SG-O/MiniFeedMaster/README.MD

# Mainboard for automated SMT Feeder system #

## Documentation ##

You can find the manufacturing documentation [here.](https://github.com/SG-O/MiniFeedMaster/tree/master/Doc)

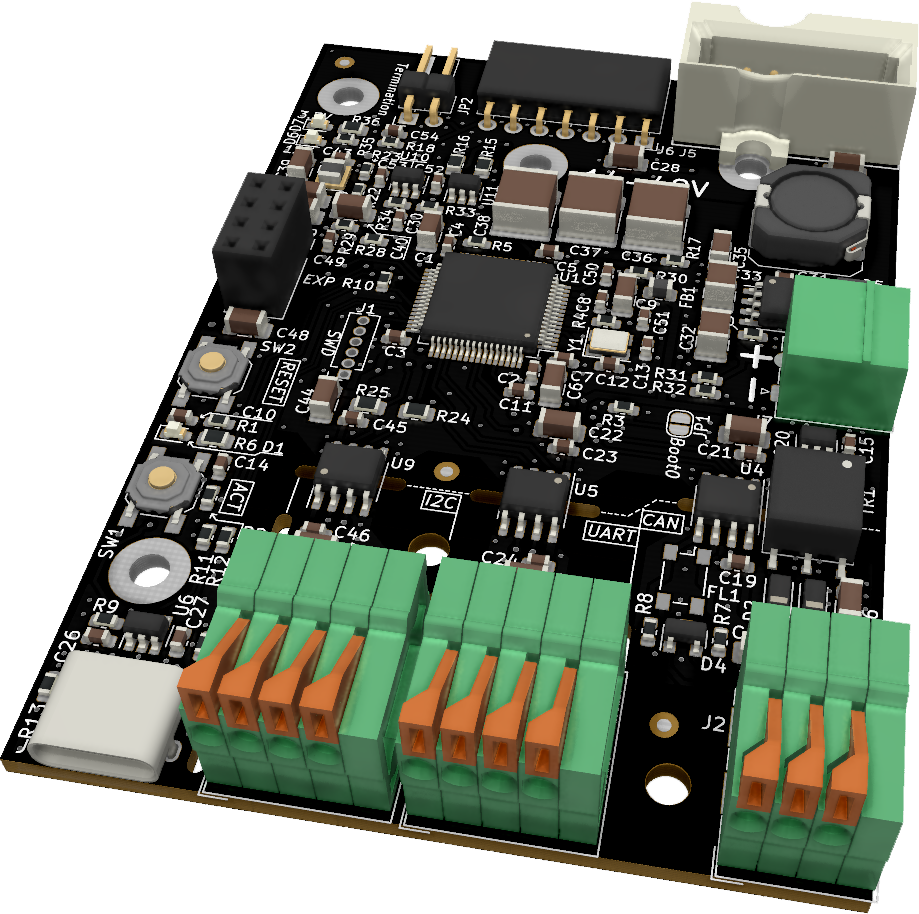
[picture p1: Doc/MiniFeedMaster1.png]
