SG-O/MiniFeedMaster/Doc/README.MD

# Manufacturing Documentation #

## Schematic ##

You can view the schematic [here.](https://github.com/SG-O/MiniFeedMaster/blob/master/Doc/MiniFeedMaster.pdf "Schematic")

## Gerber Files ##

Gerber files for this board can be found [here.](https://github.com/SG-O/MiniFeedMaster/releases "Releases")

## BOM ##

The BOM **without** the CAN circuit populated is available [here.](https://github.com/SG-O/MiniFeedMaster/blob/master/Doc/MiniFeedMasterBOM_nocan.csv "No CAN BOM")

The BOM **with** the CAN circuit populated is available [here.](https://github.com/SG-O/MiniFeedMaster/blob/master/Doc/MiniFeedMasterBOM_can.csv "CAN BOM")

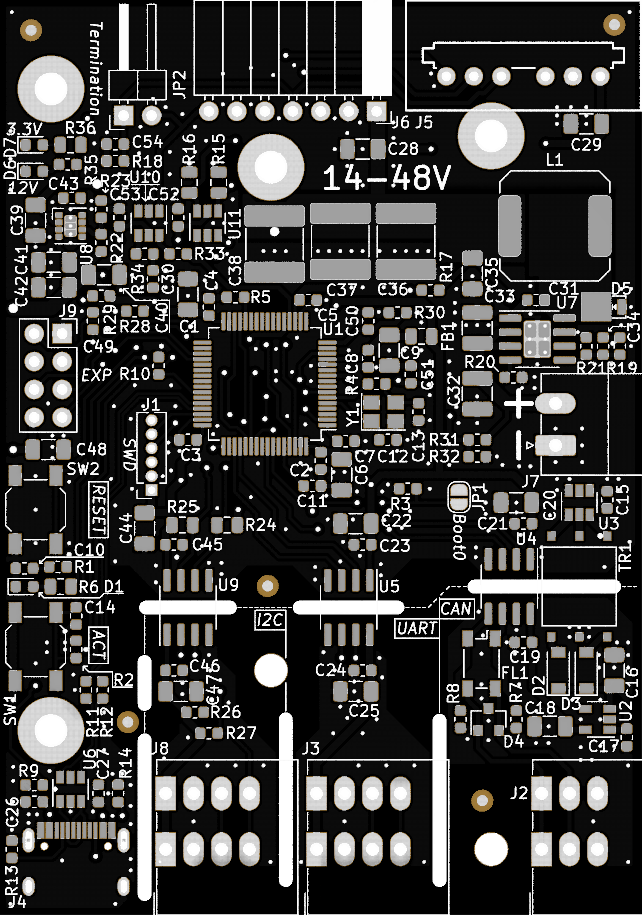
[picture p2: Doc/MiniFeedMasterTop.png]
