SG-O/MiniFeedMaster/Doc/MiniFeedMaster2.png

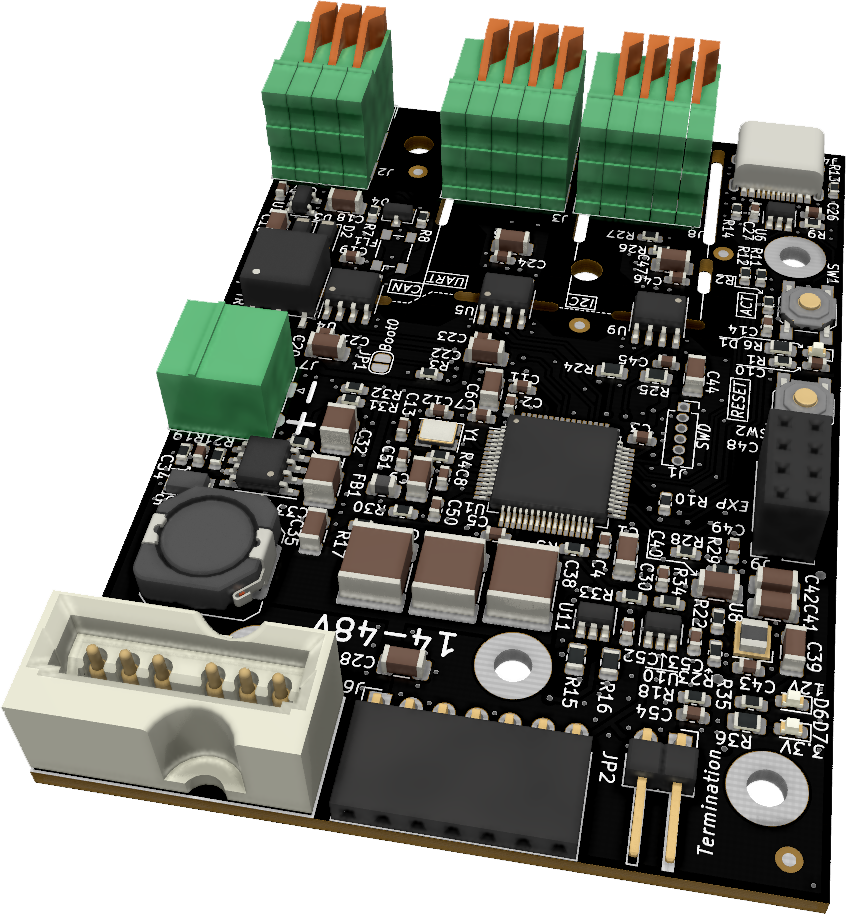
Doc/MiniFeedMaster2.png
