SG-O/MiniFeedMaster/Doc/MiniFeedMaster3.png

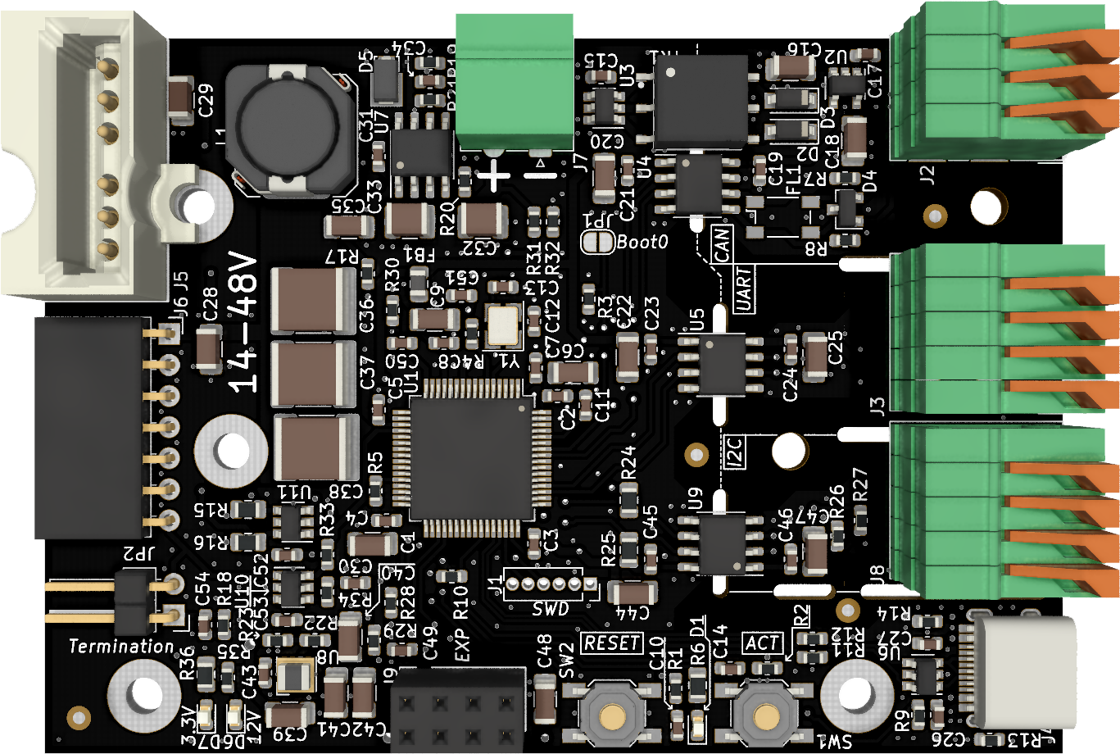
Doc/MiniFeedMaster3.png
