SG-O/MiniFeedMaster/Doc/MiniFeedMasterBottom.png

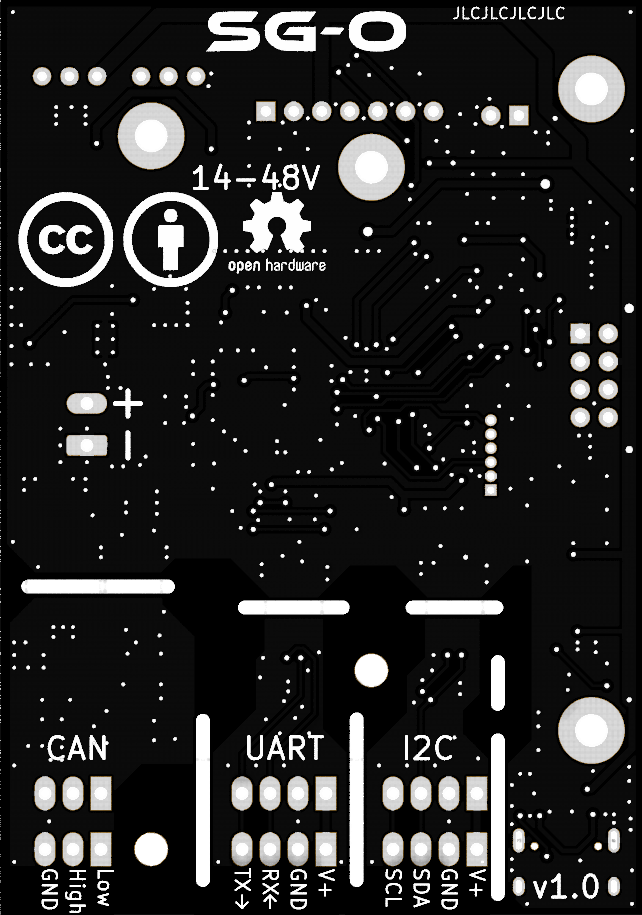
Doc/MiniFeedMasterBottom.png
