SG-O/MiniFeedMaster/Doc/MiniFeedMaster.pdf

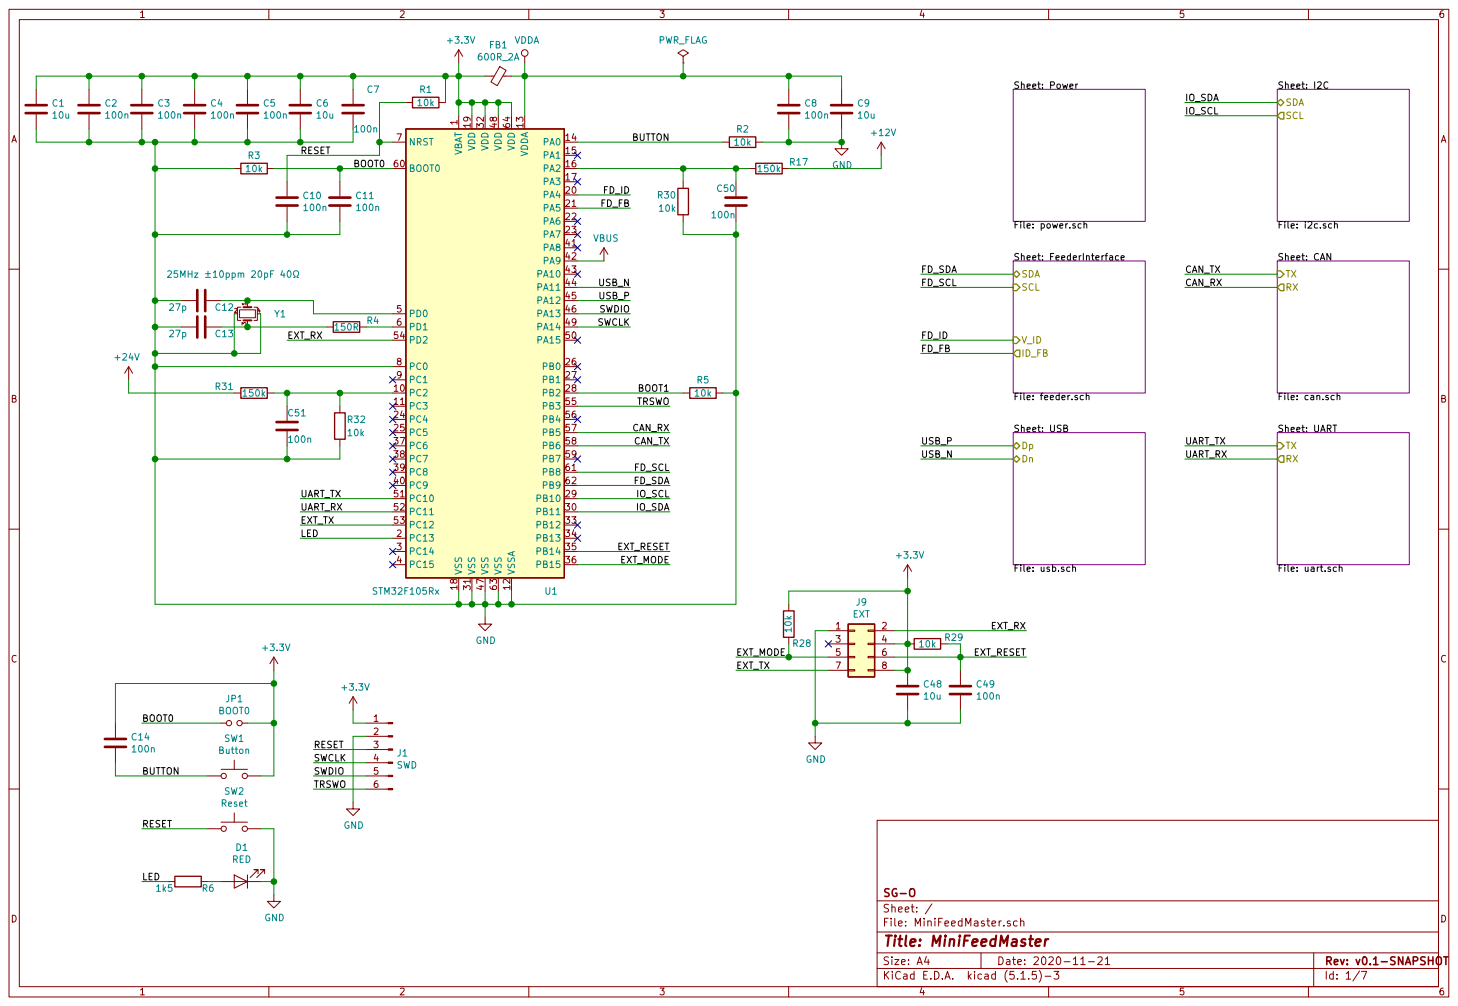
[picture p6: page 1]

File: usb.sch Dn Dp C3

File: i2c.sch SCL SDA

1 VDD 19 VDD 32 VDD 48 VDD 64 VDDA 13 VSS 18 VSS 31 VSS 47 VSS 63 VSSA 12 STM32F105Rx U1

Sheet: FeederInterface File: feeder.sch SDA
SCL V_ID

Sheet: CAN
File: can.sch TXRX

Sheet: UART
File: uart.sch TXRX

Id: 1/7 Title: MiniFeedMaster File: MiniFeedMaster.sch Sheet: / SG-O

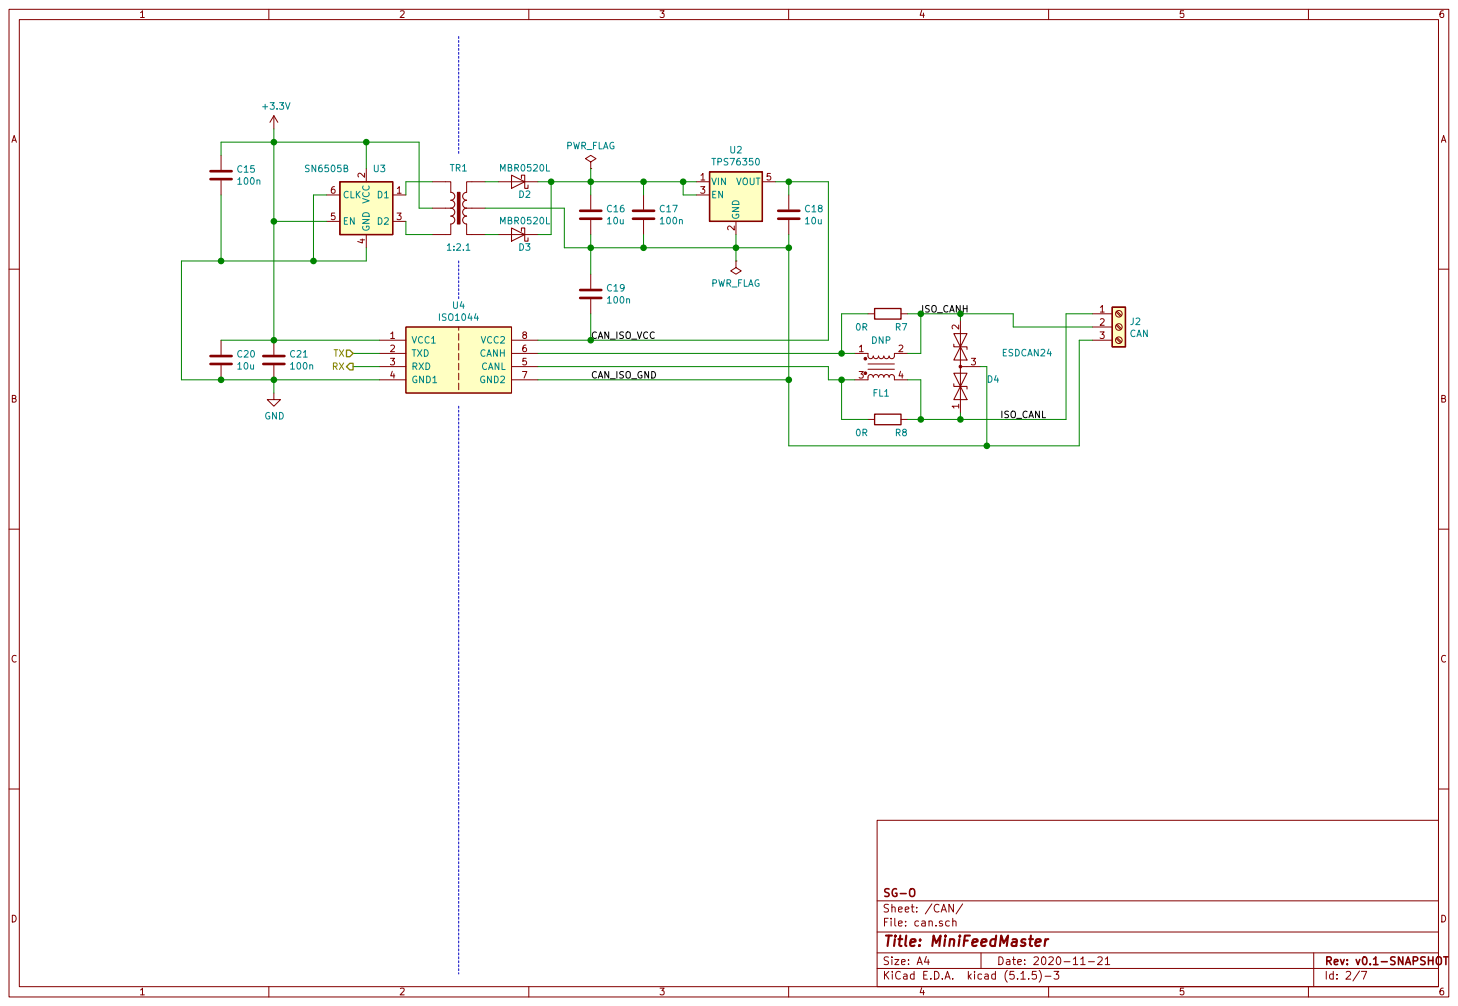
[picture p7: page 2]

Id: 2/7 Title: MiniFeedMaster File: can.sch Sheet: /CAN/ SG-O

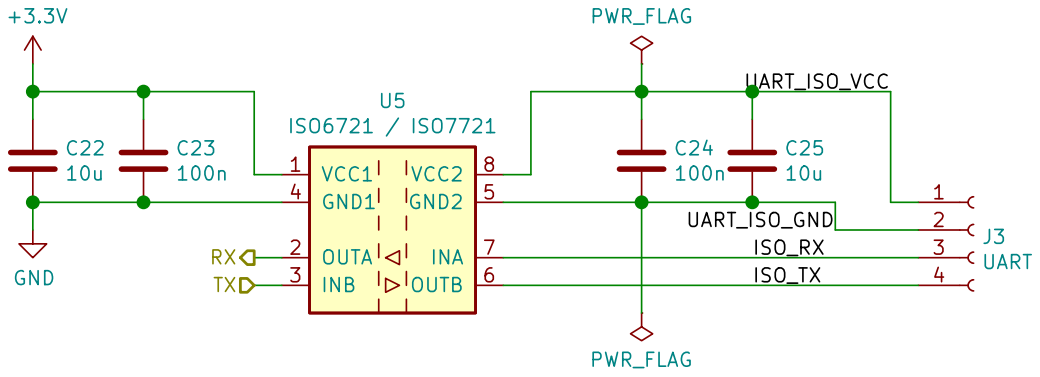
[picture p8: page 3]

Id: 3/7 Title: MiniFeedMaster File: uart.sch Sheet: /UART/ SG-O

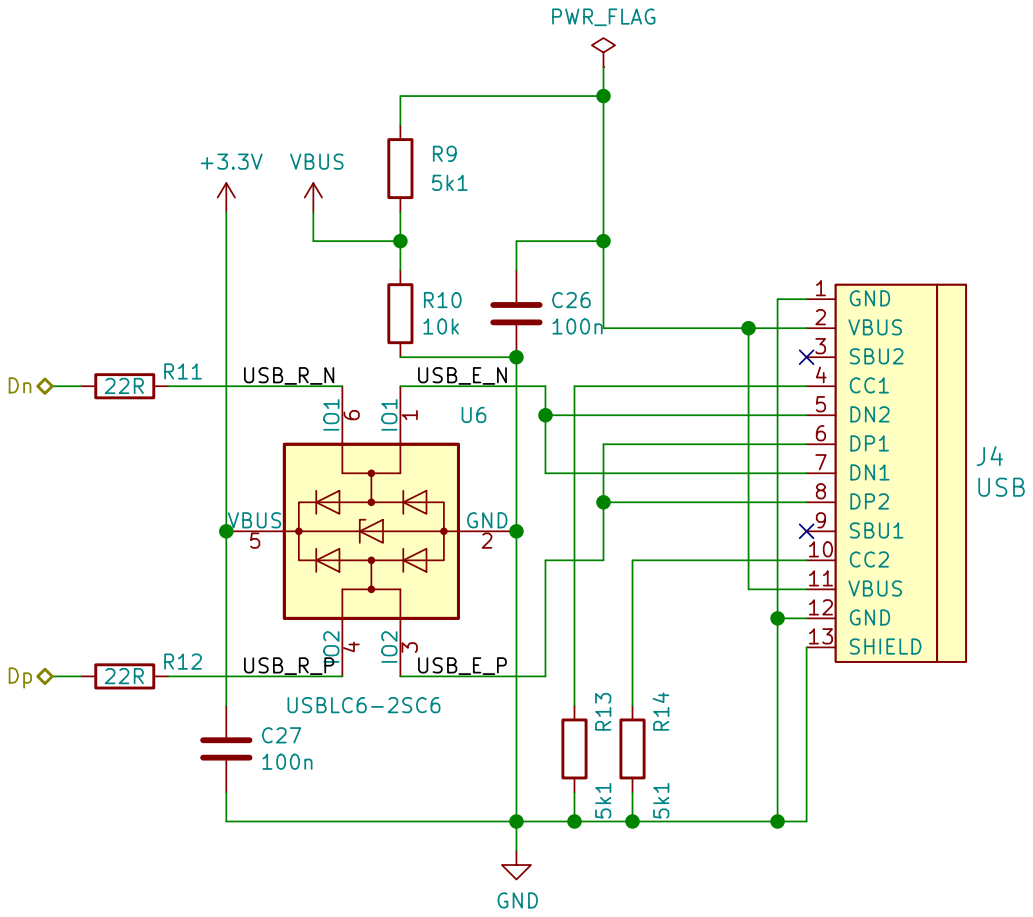
[picture p9: page 4]

Id: 4/7 Title: MiniFeedMaster File: usb.sch Sheet: /USB/ SG-O

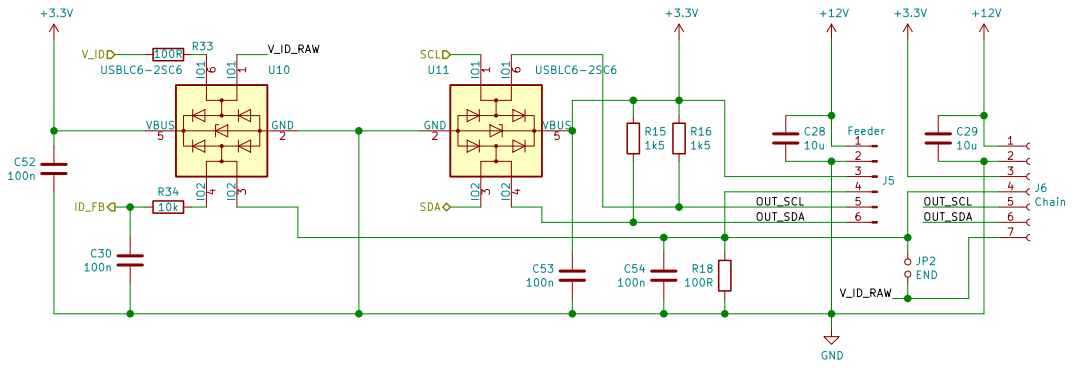
[picture p10: page 5]

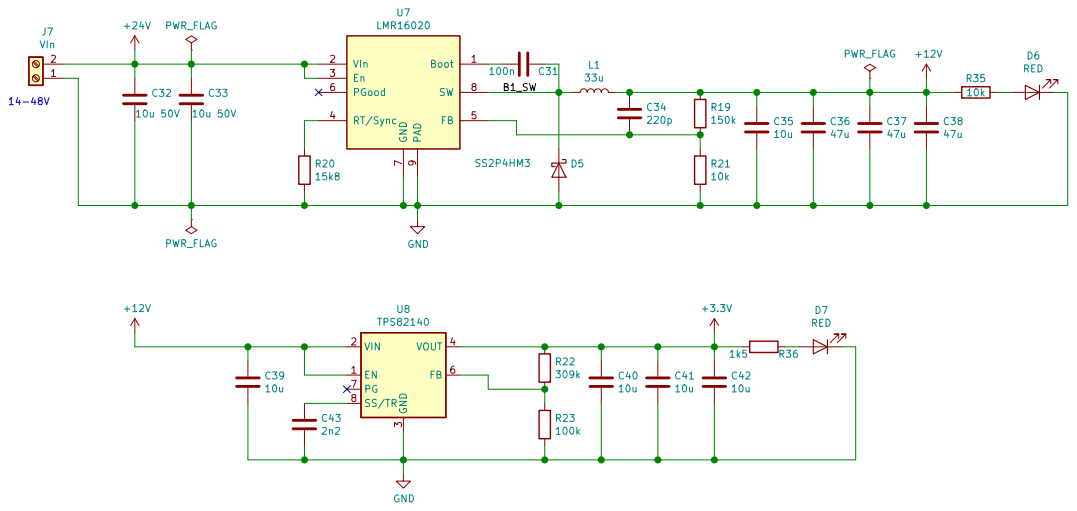
[picture p11: page 6]

3 VOUT 4 FB 6 PG 7 SS/TR 8 U8 TPS82140 +12V C33

File: power.sch Sheet: /Power/ SG-O

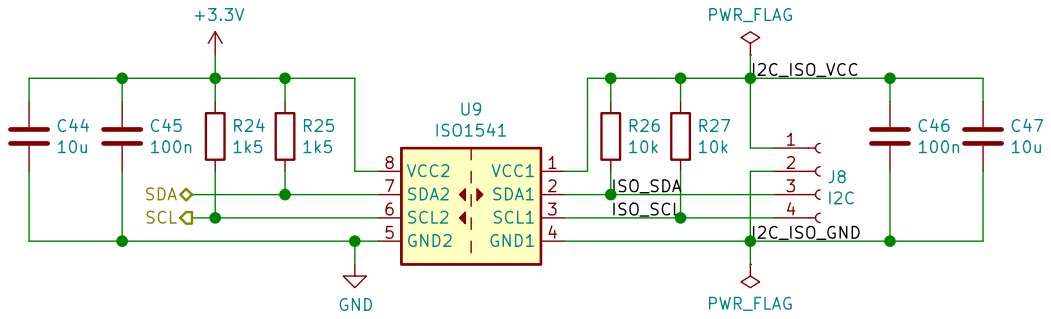
[picture p12: page 7]

Id: 7/7 Title: MiniFeedMaster File: i2c.sch Sheet: /I2C/ SG-O
