SG-O/MiniFeedMaster/MiniFeedMaster.kicad_pcb

## KiCad design MiniFeedMaster.kicad_pcb (2021-02-03)

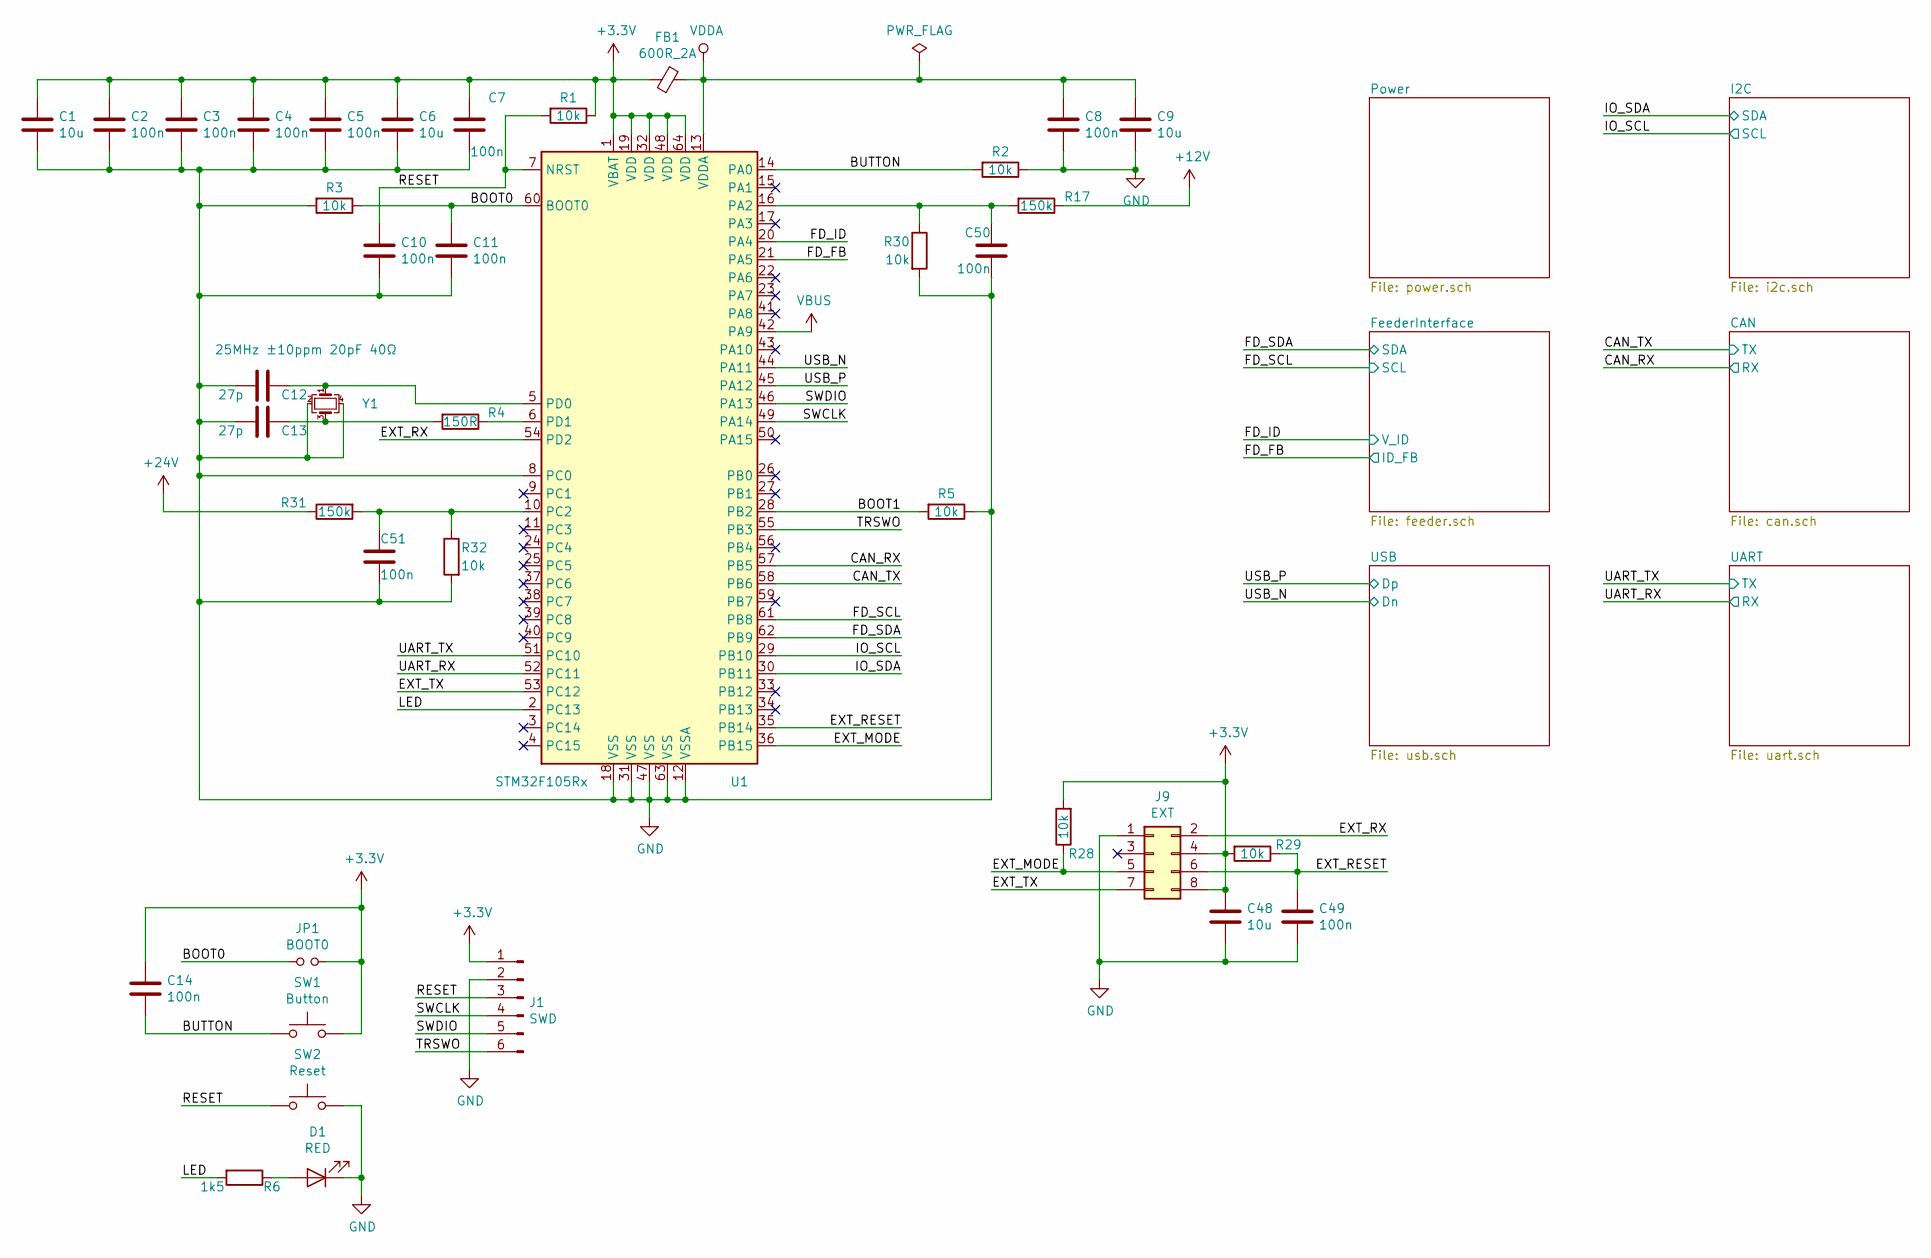
[picture p13: schematic MiniFeedMaster.sch]

Parts:
C1, C6, C9, C48: 10u; C_1206_3216Metric; lcsc# C14860
C2, C3, C4, C5, C7, C8, C10, C11, C14, C49, C50, C51: 100n; C_0603_1608Metric; lcsc# C1591
C12, C13: 27p; C_0603_1608Metric; lcsc# C107045
D1: RED; LED_0603_1608Metric; lcsc# C118330
FB1: 600R_2A; L_0805_2012Metric; lcsc# C81034
J1: SWD; PinSocket_1x06_P1.27mm_Vertical
J9: EXT; PinSocket_2x04_P2.54mm_Vertical; lcsc# C92271
JP1: BOOT0; SolderJumper-2_P1.3mm_Open_RoundedPad1.0x1.5mm
R1, R2, R3, R5, R28, R29, R30, R32: 10k; R_0603_1608Metric; lcsc# C128781
R4: 150R; R_0603_1608Metric; lcsc# C319856
R6: 1k5; R_0805_2012Metric; lcsc# C118217
R17, R31: 150k; R_0603_1608Metric; lcsc# C311920
SW1: Button; SW_SPST_SKQG_WithStem; lcsc# C318889
SW2: Reset; SW_SPST_SKQG_WithStem; lcsc# C318889
U1: STM32F105Rx; LQFP-64_10x10mm_P0.5mm; lcsc# C80986
Y1: 25MHz ±10ppm 20pF 40Ω; Crystal_SMD_3225-4Pin_3.2x2.5mm; lcsc# C709159

Connections:
+3V3: C1.1, C2.1, C3.1, C4.1, C5.1, C6.1, C7.1, C14.1, C48.1, FB1.2, J1.1, J9.4, J9.8, JP1.2, R1.1, R28.2, R29.2, SW1.2, U1.1 (VBAT), U1.19 (VDD), U1.32 (VDD), U1.48 (VDD), U1.64 (VDD); also elsewhere on the board
+12V: R17.1; also elsewhere on the board
+24V: R31.1; also elsewhere on the board
/BOOT0: C11.1, JP1.1, R3.1, U1.60 (BOOT0)
/BOOT1: R5.2, U1.28 (PB2)
/BUTTON: C14.2, R2.2, SW1.1, U1.14 (PA0)
/CAN_RX: U1.57 (PB5); also elsewhere on the board
/CAN_TX: U1.58 (PB6); also elsewhere on the board
/EXT_MODE: J9.5, R28.1, U1.36 (PB15)
/EXT_RESET: C49.1, J9.6, R29.1, U1.35 (PB14)
/EXT_RX: J9.2, U1.54 (PD2)
/EXT_TX: J9.7, U1.53 (PC12)
/FD_FB: U1.21 (PA5); also elsewhere on the board
/FD_ID: U1.20 (PA4); also elsewhere on the board
/FD_SCL: U1.61 (PB8); also elsewhere on the board
/FD_SDA: U1.62 (PB9); also elsewhere on the board
/IO_SCL: U1.29 (PB10); also elsewhere on the board
/IO_SDA: U1.30 (PB11); also elsewhere on the board
/LED: R6.2, U1.2 (PC13)
/RESET: C10.1, J1.3, R1.2, SW2.1, U1.7 (NRST)
/SWCLK: J1.4, U1.49 (PA14)
/SWDIO: J1.5, U1.46 (PA13)
/TRSWO: J1.6, U1.55 (PB3)
/UART_RX: U1.52 (PC11); also elsewhere on the board
/UART_TX: U1.51 (PC10); also elsewhere on the board
/USB_N: U1.44 (PA11); also elsewhere on the board
/USB_P: U1.45 (PA12); also elsewhere on the board
GND: C1.2, C2.2, C3.2, C4.2, C5.2, C6.2, C7.2, C8.2, C9.2, C10.2, C11.2, C12.2, C13.2, C48.2, C49.2, C50.2, C51.2, D1.1 (K), J1.2, J9.1, R2.1, R3.2, R5.1, R30.2, R32.2, SW2.2, U1.8 (PC0), U1.12 (VSSA), U1.18 (VSS), U1.31 (VSS), U1.47 (VSS), U1.63 (VSS), Y1.2, Y1.4; also elsewhere on the board
unnamed: C12.1, U1.5 (PD0), Y1.1
unnamed: C13.1, R4.2, Y1.3
unnamed: C50.1, R17.2, R30.1, U1.16 (PA2)
unnamed: C51.1, R31.2, R32.1, U1.10 (PC2)
unnamed: D1.2 (A), R6.1
unnamed: R4.1, U1.6 (PD1)
VBUS: U1.42 (PA9); also elsewhere on the board
VDDA: C8.1, C9.1, FB1.1, U1.13 (VDDA)

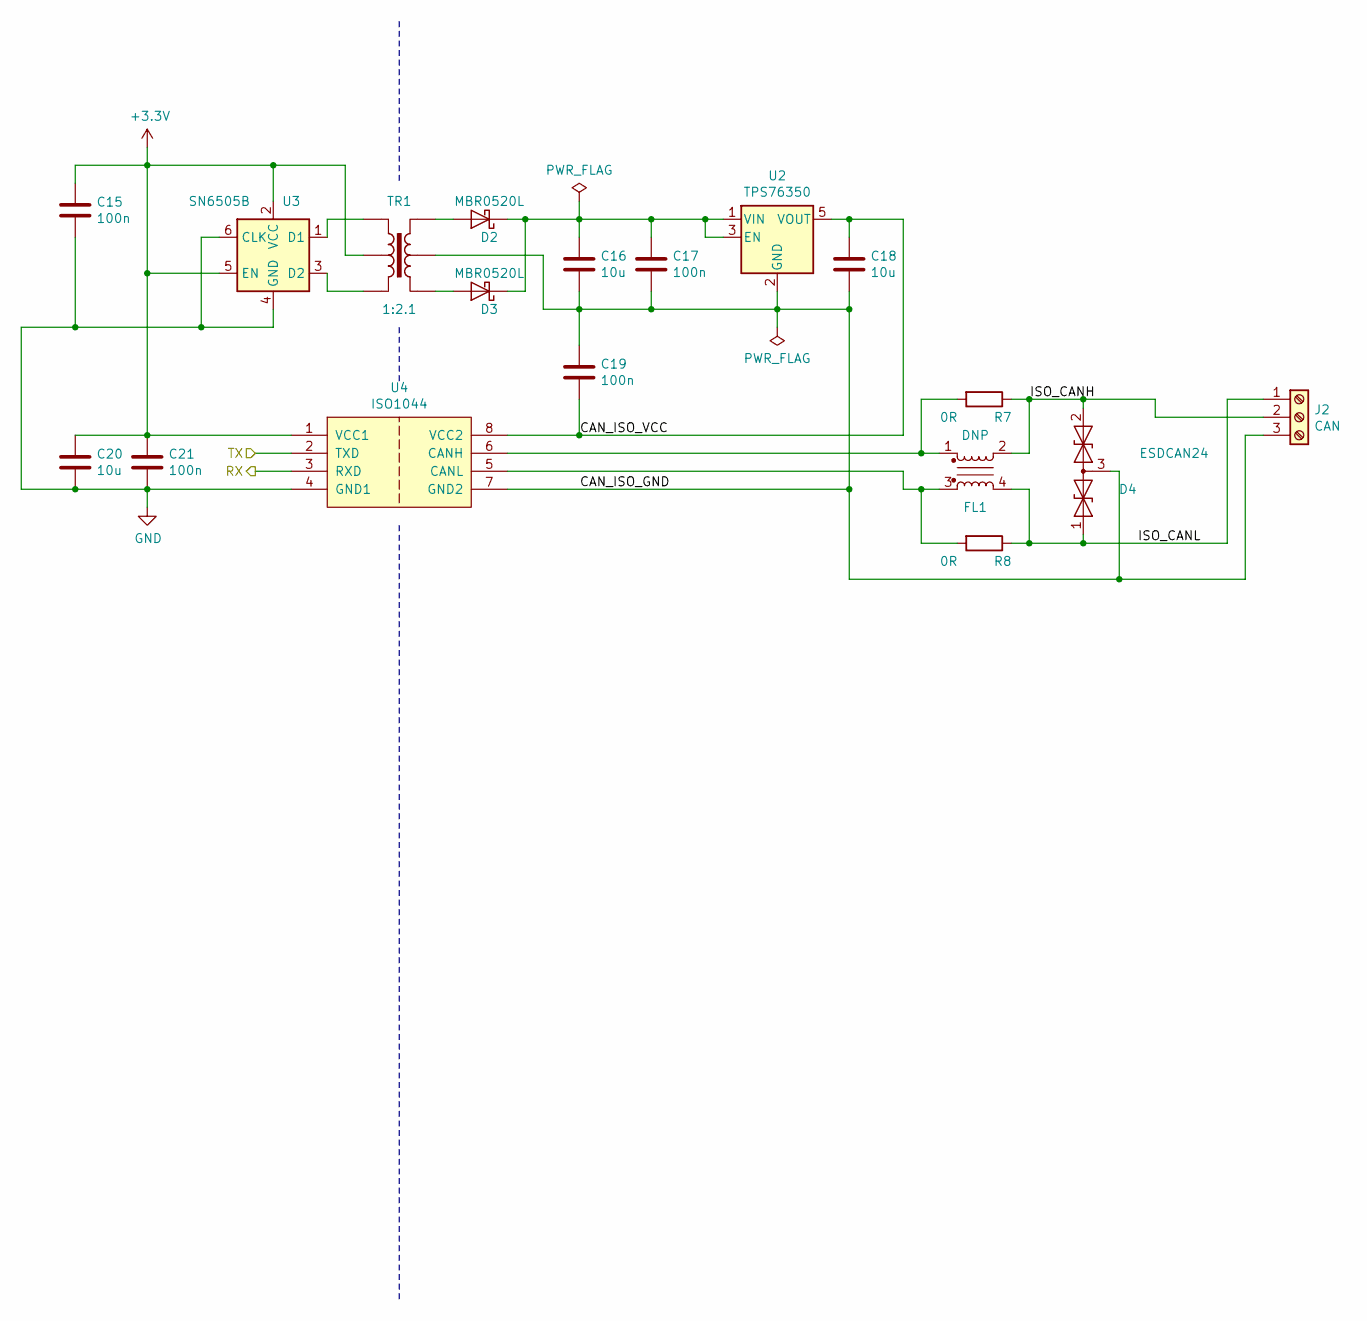
[picture p14: schematic can.sch, MiniFeedMaster]

Parts:
C15, C17, C19, C21: 100n; C_0603_1608Metric; lcsc# C1591
C16, C18, C20: 10u; C_1206_3216Metric; lcsc# C14860
D2, D3: MBR0520L; D_SOD-123; lcsc# C23848
D4: ESDCAN24; SOT-23; lcsc# C246766
FL1: DNP; FIL_ACT45B-510-2P-TL003; lcsc# C76584
J2: CAN; TerminalBlock_KaiFeng_KF141R-3_1x03_P2.54mm; lcsc# C475125
R7, R8: 0R; R_0603_1608Metric; lcsc# C163836
TR1: 1:2.1; TOROID_SMD_6PIN_(1109)
U2: TPS76350; SOT-23-5; lcsc# C194609
U3: SN6505B; SOT-23-6; lcsc# C74518
U4: ISO1044; SOIC-8_3.9x4.9mm_P1.27mm

Connections:
+3V3: C15.1, C20.1, C21.1, TR1.2, U3.2 (VCC), U3.5 (EN), U4.1 (VCC1); also elsewhere on the board
/CAN/CAN_ISO_GND: C16.2, C17.2, C18.2, C19.1, D4.3 (common), J2.3, TR1.5, U2.2 (GND), U4.7 (GND2)
/CAN/CAN_ISO_VCC: C18.1, C19.2, U2.5 (VOUT), U4.8 (VCC2)
/CAN/ISO_CANH: D4.2 (A2), FL1.2, J2.2, R7.1
/CAN/ISO_CANL: D4.1 (A1), FL1.4, J2.1, R8.1
/CAN_RX: U4.3 (RXD); also elsewhere on the board
/CAN_TX: U4.2 (TXD); also elsewhere on the board
GND: C15.2, C20.2, C21.2, U3.4 (GND), U3.6 (CLK), U4.4 (GND1); also elsewhere on the board
unnamed: C16.1, C17.1, D2.1 (K), D3.1 (K), U2.1 (VIN), U2.3 (EN)
unnamed: D2.2 (A), TR1.4
unnamed: D3.2 (A), TR1.6
unnamed: FL1.1, R7.2, U4.6 (CANH)
unnamed: FL1.3, R8.2, U4.5 (CANL)
unnamed: TR1.1, U3.3 (D2)
unnamed: TR1.3, U3.1 (D1)

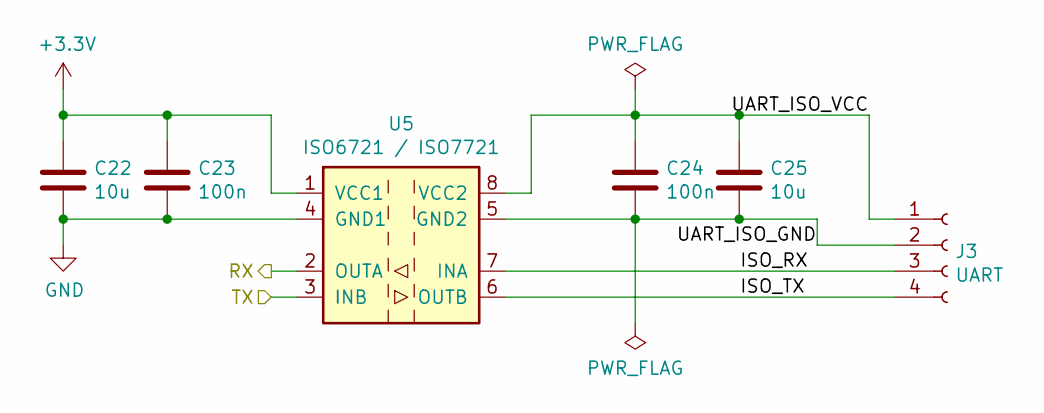
[picture p15: schematic uart.sch, MiniFeedMaster]

Parts:
C22, C25: 10u; C_1206_3216Metric; lcsc# C14860
C23, C24: 100n; C_0603_1608Metric; lcsc# C1591
J3: UART; TerminalBlock_KaiFeng_KF141R-4_1x04_P2.54mm; lcsc# C475126
U5: ISO6721 / ISO7721; SOIC-8_3.9x4.9mm_P1.27mm; lcsc# C366164

Connections:
+3V3: C22.1, C23.1, U5.1 (VCC1); also elsewhere on the board
/UART/ISO_RX: J3.3, U5.7 (INA)
/UART/ISO_TX: J3.4, U5.6 (OUTB)
/UART/UART_ISO_GND: C24.2, C25.2, J3.2, U5.5 (GND2)
/UART/UART_ISO_VCC: C24.1, C25.1, J3.1, U5.8 (VCC2)
/UART_RX: U5.2 (OUTA); also elsewhere on the board
/UART_TX: U5.3 (INB); also elsewhere on the board
GND: C22.2, C23.2, U5.4 (GND1); also elsewhere on the board

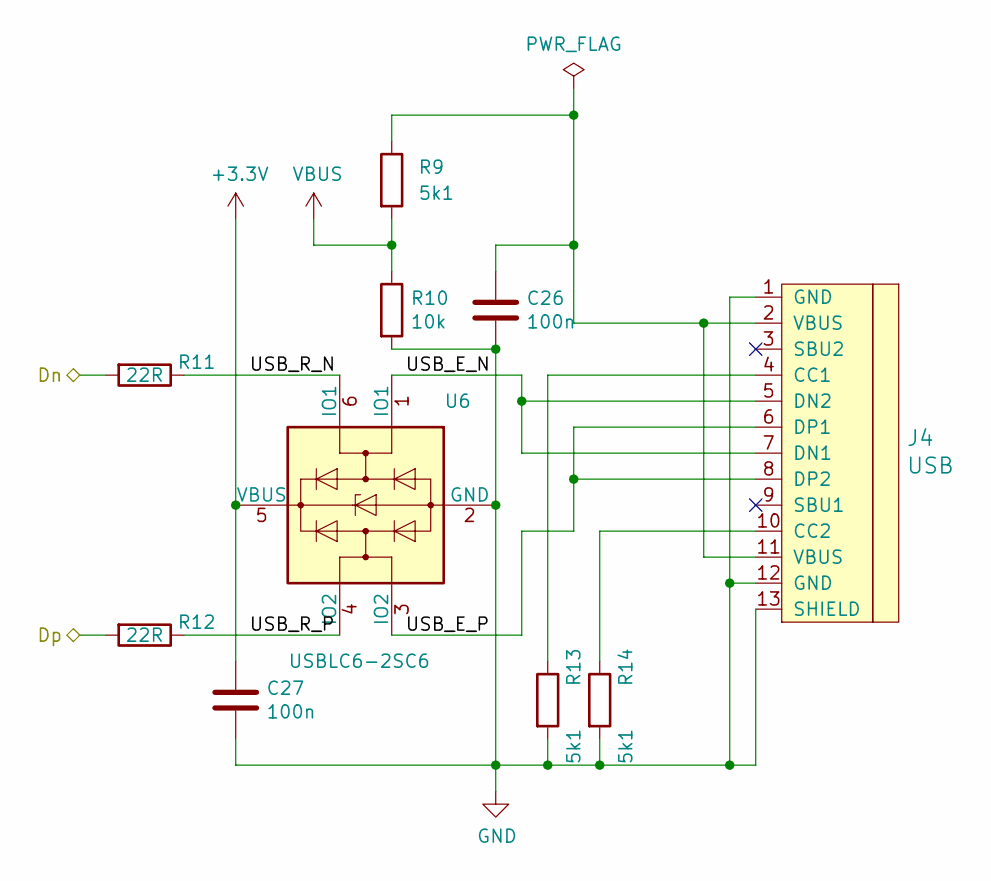
[picture p16: schematic usb.sch, MiniFeedMaster]

Parts:
C26, C27: 100n; C_0603_1608Metric; lcsc# C1591
J4: USB; HRO-TYPE-C-31-M-12-Assembly; lcsc# C165948
R9, R13, R14: 5k1; R_0603_1608Metric; lcsc# C425650
R10: 10k; R_0603_1608Metric; lcsc# C128781
R11, R12: 22R; R_0603_1608Metric; lcsc# C186356
U6: USBLC6-2SC6; SOT-23-6; lcsc# C558442

Connections:
+3V3: C27.1, U6.5 (VBUS); also elsewhere on the board
/USB/USB_E_N: J4.5 (DN2), J4.7 (DN1), U6.1 (IO1)
/USB/USB_E_P: J4.6 (DP1), J4.8 (DP2), U6.3 (IO2)
/USB/USB_R_N: R11.1, U6.6 (IO1)
/USB/USB_R_P: R12.1, U6.4 (IO2)
/USB_N: R11.2; also elsewhere on the board
/USB_P: R12.2; also elsewhere on the board
GND: C26.2, C27.2, J4.1 (GND), J4.12 (GND), J4.13 (SHIELD), R10.2, R13.2, R14.2, U6.2 (GND); also elsewhere on the board
unnamed: C26.1, J4.2 (VBUS), J4.11 (VBUS), R9.1
unnamed: J4.4 (CC1), R13.1
unnamed: J4.10 (CC2), R14.1
VBUS: R9.2, R10.1; also elsewhere on the board

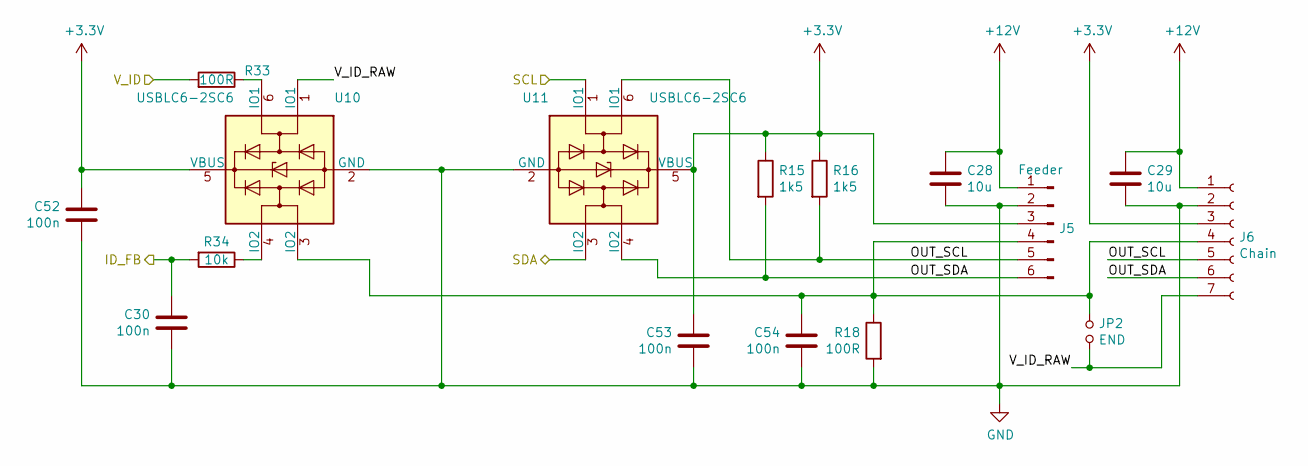
[picture p17: schematic feeder.sch, MiniFeedMaster]

Parts:
C28, C29: 10u; C_1206_3216Metric; lcsc# C14860
C30, C52, C53, C54: 100n; C_0603_1608Metric; lcsc# C1591
J5: Feeder; PogoEdgeConnector
J6: Chain; PinSocket_1x07_P2.54mm_Horizontal; lcsc# C225515
JP2: END; PinHeader_1x02_P2.54mm_Horizontal; lcsc# C376120;C5305
R15, R16: 1k5; R_0805_2012Metric; lcsc# C118217
R18, R33: 100R; R_0603_1608Metric; lcsc# C217683
R34: 10k; R_0603_1608Metric; lcsc# C128781
U10, U11: USBLC6-2SC6; SOT-23-6; lcsc# C558442

Connections:
+3V3: C52.1, C53.1, J5.3, J6.3, R15.1, R16.1, U10.5 (VBUS), U11.5 (VBUS); also elsewhere on the board
+12V: C28.1, C29.1, J5.1, J6.1; also elsewhere on the board
/FD_FB: C30.1, R34.2; also elsewhere on the board
/FD_ID: R33.2; also elsewhere on the board
/FD_SCL: U11.1 (IO1); also elsewhere on the board
/FD_SDA: U11.3 (IO2); also elsewhere on the board
/FeederInterface/OUT_SCL: J5.5, J6.5, R16.2, U11.6 (IO1)
/FeederInterface/OUT_SDA: J5.6, J6.6, R15.2, U11.4 (IO2)
/FeederInterface/V_ID_RAW: J6.7, JP2.2, U10.1 (IO1)
GND: C28.2, C29.2, C30.2, C52.2, C53.2, C54.2, J5.2, J6.2, R18.2, U10.2 (GND), U11.2 (GND); also elsewhere on the board
unnamed: C54.1, J5.4, J6.4, JP2.1, R18.1, U10.3 (IO2)
unnamed: R33.1, U10.6 (IO1)
unnamed: R34.1, U10.4 (IO2)

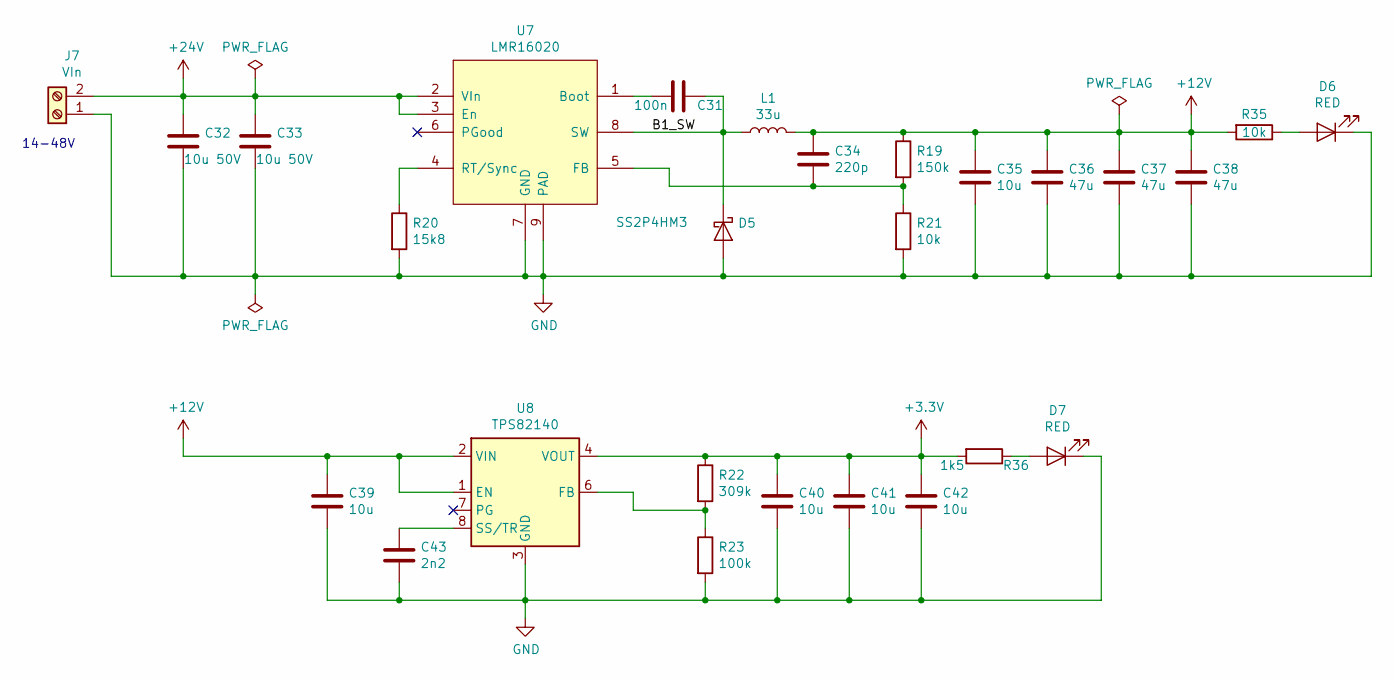
[picture p18: schematic power.sch, MiniFeedMaster]

Parts:
C31: 100n; C_0603_1608Metric; lcsc# C1591
C32, C33: 10u 50V; C_1210_3225Metric; lcsc# C337485
C34: 220p; C_0603_1608Metric; lcsc# C27675
C35, C39, C40, C41, C42: 10u; C_1206_3216Metric; lcsc# C14860
C36, C37, C38: 47u; C_2220_5650Metric; lcsc# C342293
C43: 2n2; C_0603_1608Metric; lcsc# C16033
D5: SS2P4HM3; DO-220AA; lcsc# C467996
D6, D7: RED; LED_0603_1608Metric; lcsc# C118330
J7: VIn; PhoenixContact_MC_1,5_2-G-3.81_1x02_P3.81mm_Horizontal; lcsc# C8387;C8466
L1: 33u; Inductor10x10mm; lcsc# C253612
R19: 150k; R_0603_1608Metric; lcsc# C311920
R20: 15k8; R_0603_1608Metric; lcsc# C149924
R21, R35: 10k; R_0603_1608Metric; lcsc# C128781
R22: 309k; R_0603_1608Metric; lcsc# C56054
R23: 100k; R_0603_1608Metric; lcsc# C133733
R36: 1k5; R_0805_2012Metric; lcsc# C118217
U7: LMR16020; SOIC-8-1EP_3.9x4.9mm_P1.27mm_EP2.41x3.3mm_ThermalVias; lcsc# C190006
U8: TPS82140; Texas_SIL0008D_MicroSiP-8-1EP_2.8x3mm_P0.65mm_EP1.1x1.9mm_T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; lcsc# C544385

Connections:
+3V3: C40.1, C41.1, C42.1, R22.1, R36.2, U8.4 (VOUT), U8.5 (VOUT); also elsewhere on the board
+12V: C34.1, C35.1, C36.1, C37.1, C38.1, C39.1, L1.2, R19.1, R35.2, U8.1 (EN), U8.2 (VIN); also elsewhere on the board
+24V: C32.1, C33.1, J7.2, U7.2 (VIn), U7.3 (En); also elsewhere on the board
/Power/B1_SW: C31.1, D5.1 (K), L1.1, U7.8 (SW)
GND: C32.2, C33.2, C35.2, C36.2, C37.2, C38.2, C39.2, C40.2, C41.2, C42.2, C43.2, D5.2 (A), D6.1 (K), D7.1 (K), J7.1, R20.2, R21.2, R23.2, U7.7 (GND), U7.9 (PAD), U8.3 (GND), U8.9 (GND); also elsewhere on the board
unnamed: C31.2, U7.1 (Boot)
unnamed: C34.2, R19.2, R21.1, U7.5 (FB)
unnamed: C43.1, U8.8 (SS/TR)
unnamed: D6.2 (A), R35.1
unnamed: D7.2 (A), R36.1
unnamed: R20.1, U7.4 (RT/Sync)
unnamed: R22.2, R23.1, U8.6 (FB)

Notes on the sheet:
14-48V

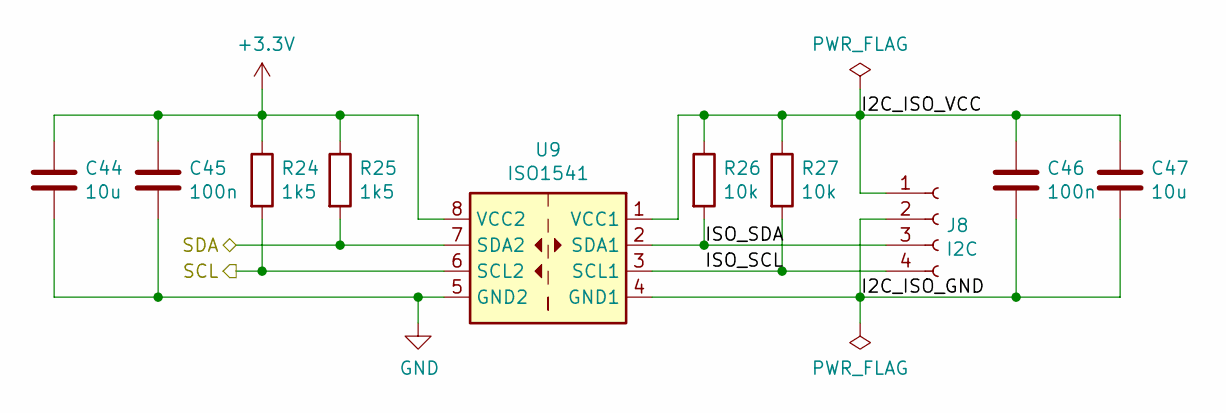
[picture p19: schematic i2c.sch, MiniFeedMaster]

Parts:
C44, C47: 10u; C_1206_3216Metric; lcsc# C14860
C45, C46: 100n; C_0603_1608Metric; lcsc# C1591
J8: I2C; TerminalBlock_KaiFeng_KF141R-4_1x04_P2.54mm; lcsc# C475126
R24, R25: 1k5; R_0805_2012Metric; lcsc# C118217
R26, R27: 10k; R_0603_1608Metric; lcsc# C128781
U9: ISO1541; SOIC-8_3.9x4.9mm_P1.27mm; lcsc# C143028

Connections:
+3V3: C44.1, C45.1, R24.1, R25.1, U9.8 (VCC2); also elsewhere on the board
/I2C/I2C_ISO_GND: C46.2, C47.2, J8.2, U9.4 (GND1)
/I2C/I2C_ISO_VCC: C46.1, C47.1, J8.1, R26.1, R27.1, U9.1 (VCC1)
/I2C/ISO_SCL: J8.4, R27.2, U9.3 (SCL1)
/I2C/ISO_SDA: J8.3, R26.2, U9.2 (SDA1)
/IO_SCL: R24.2, U9.6 (SCL2); also elsewhere on the board
/IO_SDA: R25.2, U9.7 (SDA2); also elsewhere on the board
GND: C44.2, C45.2, U9.5 (GND2); also elsewhere on the board

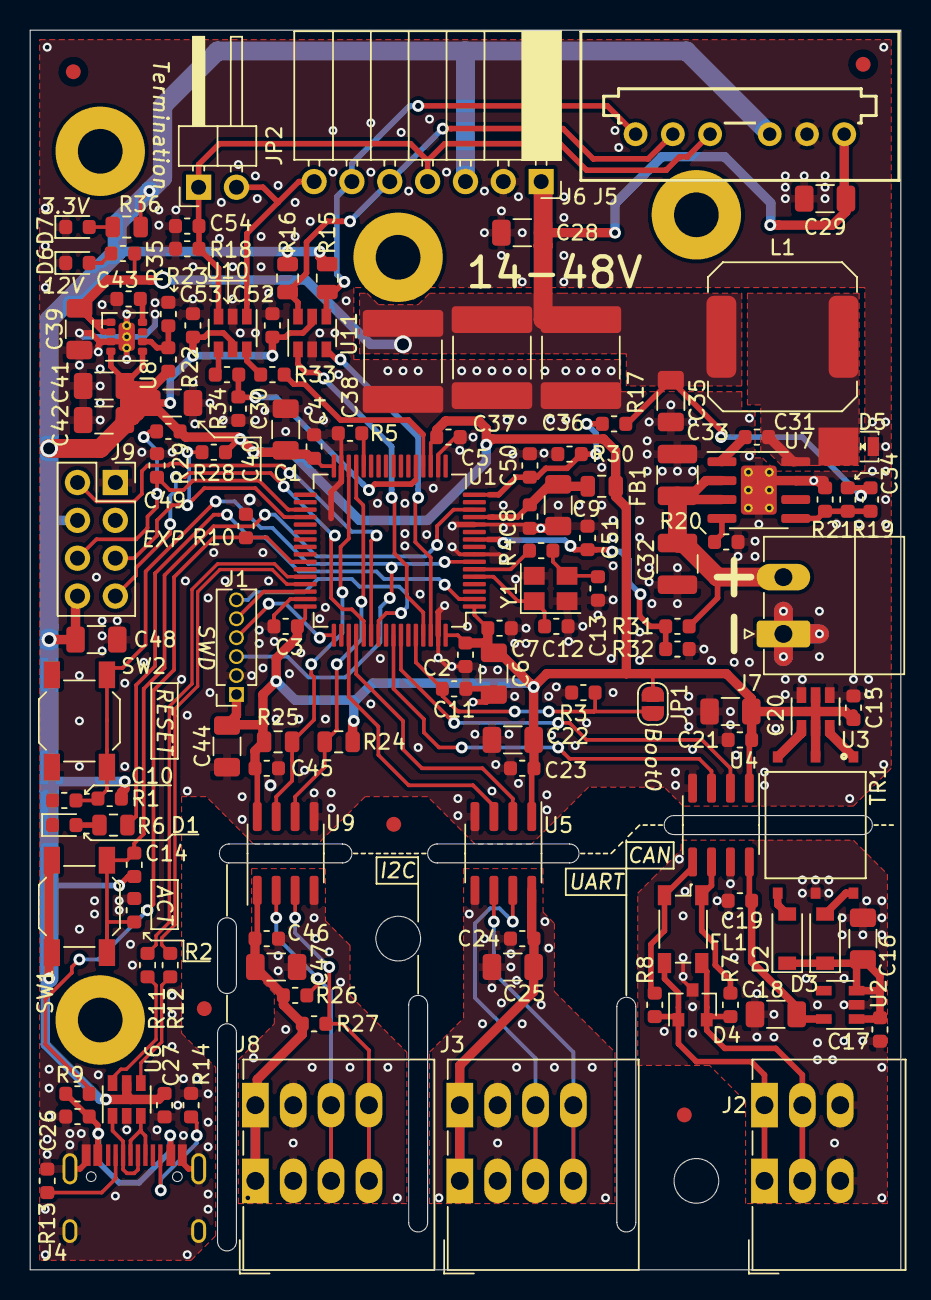
[picture p20: board MiniFeedMaster.kicad_pcb from above]

Board: 2 copper layers, 58.4 x 83.2 mm, 131 parts (0 on the bottom side), 76 nets.

Other parts of the board:
Fid1, Fid2, Fid3, Fid4, Fid5: Fiducial_1mm_Mask2mm
