SG-O/MiniFeedMaster/(commit log)

2021-01-04 Changed mounting holes from 2.5mm to 3mm Changed some 0.2mm vias to 0.3mm.
    [MiniFeedMaster.kicad_pcb]
2021-01-04 Fixed some references
    [MiniFeedMaster.kicad_pcb]
2021-01-04 Changed some 0.2mm vias to 0.3mm
    [MiniFeedMaster.kicad_pcb]
2021-02-02 Added IO Protection Switched Fault Signal to +3.3V Added Voltage sensing Added correct UART pins to EXT header
    [MiniFeedMaster.kicad_pcb, MiniFeedMaster.sch, feeder.sch]
2021-02-03 Added LEDs to indicate power on the 12V and 3.3V rails Added Fiducials Moved references for SW1 and R2 Added 3D Model
    [MiniFeedMaster.csv, MiniFeedMaster.kicad_pcb, MiniFeedMaster.sch, MiniFeedMasterBOM_can.csv, MiniFeedMasterBOM_nocan.csv, MiniFeedMasterNoCAN.csv, can.csv, can.sch]
